trnila/rfm69/hw/sensor/models/RFM69HW.STEP

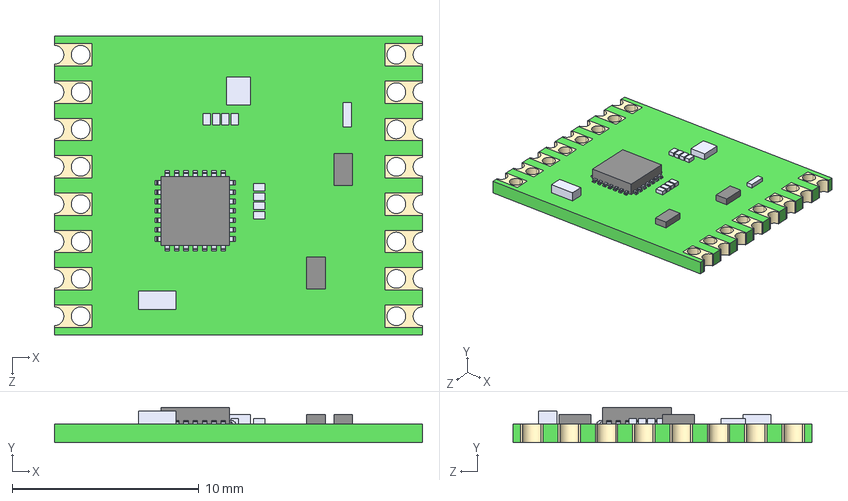
[picture p1: CAD file, 2024-07-25]
hw/sensor/models/RFM69HW.STEP
19.7 x 1.90 x 16.0 mm
