trnila/rfm69/hw/sensor/models/KF128-2.54-2P.step

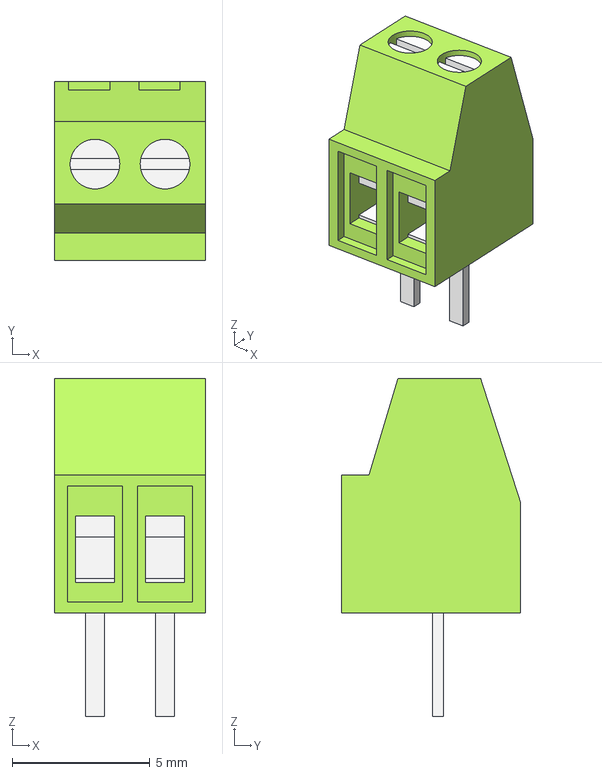
[picture p2: CAD file, 2024-07-25]
hw/sensor/models/KF128-2.54-2P.step
5.48 x 6.50 x 12.3 mm
Housing
PlasticBody
