trnila/rfm69/hw/panel/panel.kicad_pcb

## KiCad design hw/panel/panel.kicad_pcb (2024-07-29)

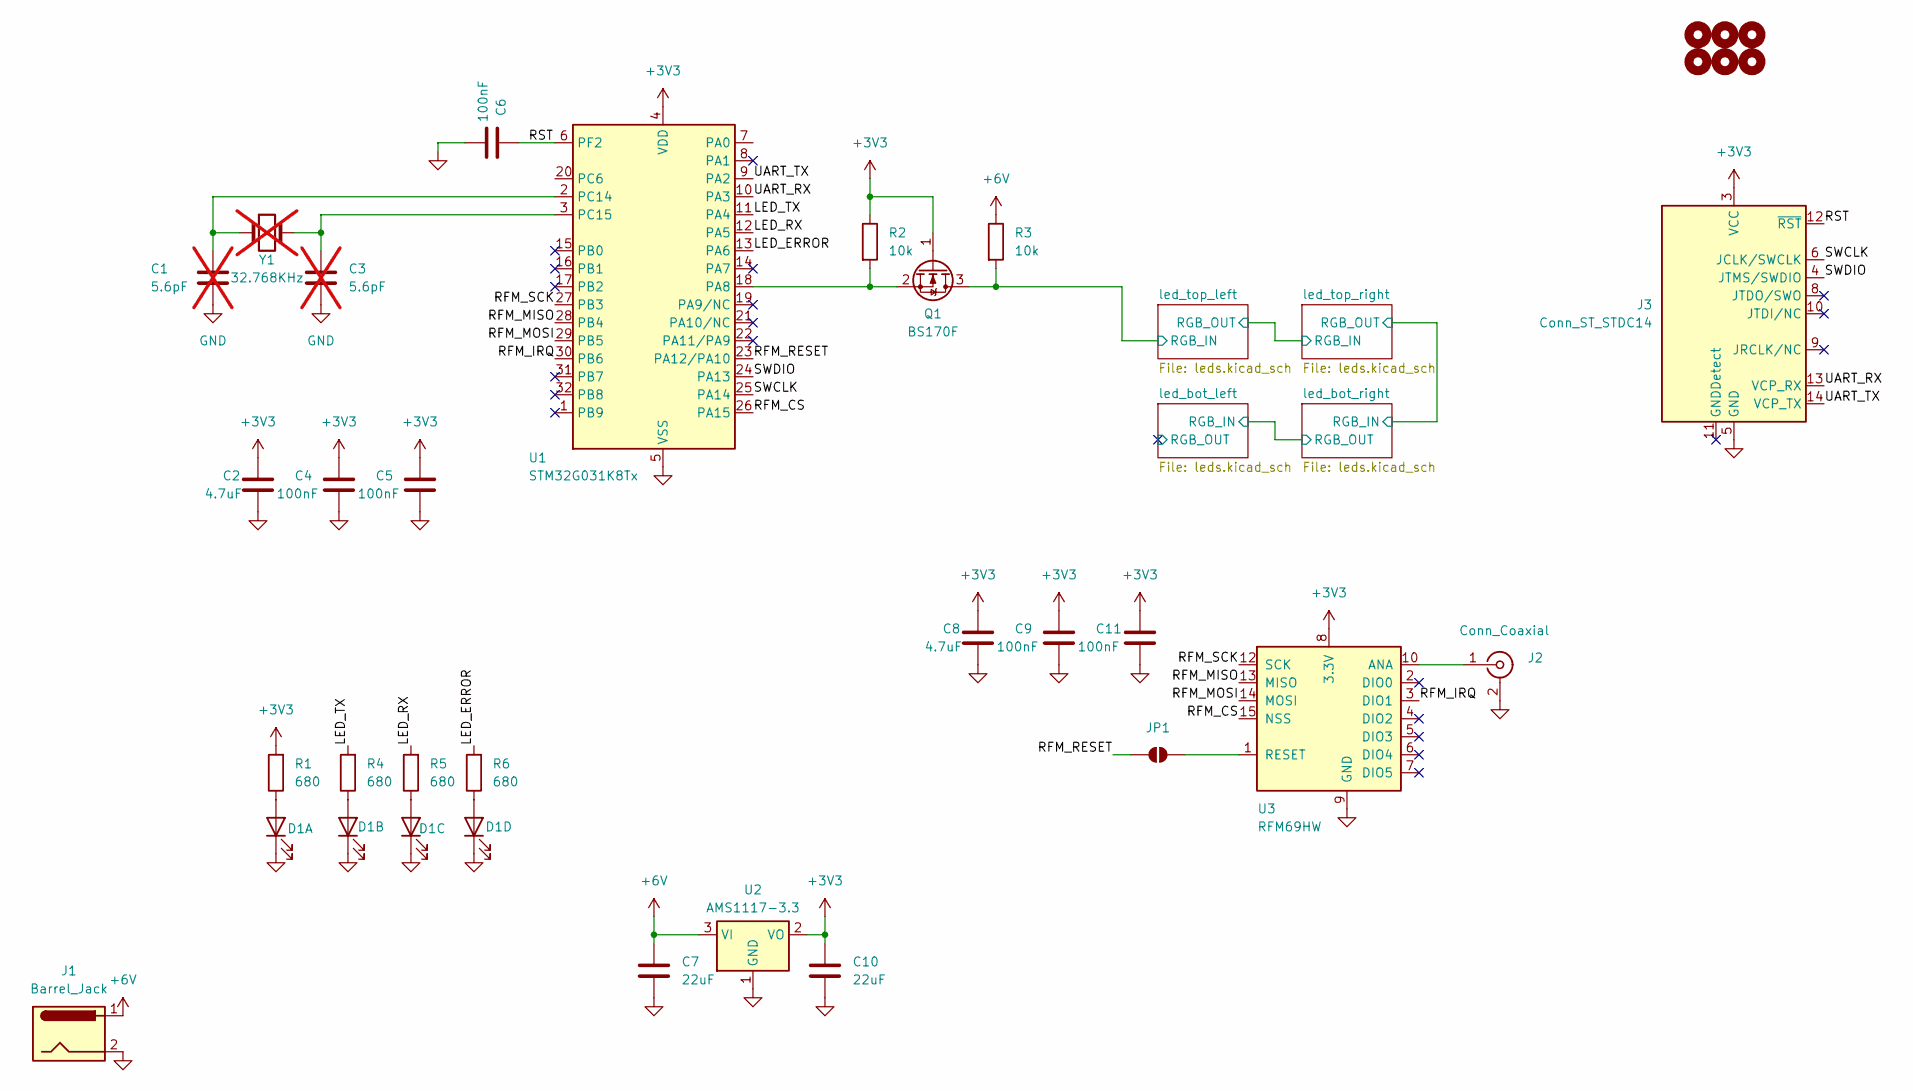
[picture p3: schematic panel.kicad_sch]

Parts:
C1, C3: 5.6pF; C_0805_2012Metric_Pad1.18x1.45mm_HandSolder; not fitted
C2, C8: 4.7uF; C_0805_2012Metric_Pad1.18x1.45mm_HandSolder
C4, C5, C6, C9, C11: 100nF; C_0805_2012Metric_Pad1.18x1.45mm_HandSolder
C7, C10: 22uF; C_1210_3225Metric
D1: light_guide
H1, H2, H3, H4, H200, H201: MountingHole; MountingHole_3.2mm_M3
J1: Barrel_Jack; Molex_Micro-Fit_3.0_43650-0200_1x02_P3.00mm_Horizontal
J2: Conn_Coaxial; SMA_Amphenol_901-143_Horizontal
J3: Conn_ST_STDC14; PinHeader_2x07_P1.27mm_Horizontal
JP1: SolderJumper_2_Bridged; SolderJumper-2_P1.3mm_Open_TrianglePad1.0x1.5mm
Q1: BS170F; SOT-23
R1, R4, R5, R6: 680; R_0805_2012Metric_Pad1.20x1.40mm_HandSolder
R2, R3: 10k; R_0805_2012Metric_Pad1.20x1.40mm_HandSolder
U1: STM32G031K8Tx; LQFP-32_7x7mm_P0.8mm
U2: AMS1117-3.3; SOT-223-3_TabPin2
U3: RFM69HW; HOPERF_RFM69HW
Y1: 32.768KHz; Crystal_SMD_3215-2Pin_3.2x1.5mm; not fitted

Connections:
+3V3: C2.1, C4.1, C5.1, C8.1, C9.1, C10.1, C11.1, J3.3 (VCC), Q1.1 (G), R1.2, R2.1, U1.4 (VDD), U2.2 (VO), U3.8 (3.3V)
+6V: C7.1, J1.1, R3.1, U2.3 (VI); also elsewhere on the board
/LED_ERROR: R6.2, U1.13 (PA6)
/LED_RX: R5.2, U1.12 (PA5)
/LED_TX: R4.2, U1.11 (PA4)
/RFM_CS: U1.26 (PA15), U3.15 (NSS)
/RFM_IRQ: U1.30 (PB6), U3.3 (DIO1)
/RFM_MISO: U1.28 (PB4), U3.13 (MISO)
/RFM_MOSI: U1.29 (PB5), U3.14 (MOSI)
/RFM_RESET: JP1.2 (B), U1.23 (PA12/PA10)
/RFM_SCK: U1.27 (PB3), U3.12 (SCK)
/RST: C6.1, J3.12 (~RST), U1.6 (PF2)
/SWCLK: J3.6 (JCLK/SWCLK), U1.25 (PA14)
/SWDIO: J3.4 (JTMS/SWDIO), U1.24 (PA13)
/UART_RX: J3.13 (VCP_RX), U1.10 (PA3)
/UART_TX: J3.14 (VCP_TX), U1.9 (PA2)
/led_top_left/RGB_IN: Q1.3 (D), R3.2; also elsewhere on the board
GND: C1.2, C2.2, C3.2, C4.2, C5.2, C6.2, C7.2, C8.2, C9.2, C10.2, C11.2, D1.1 (K), D1.3 (K), D1.5 (K), D1.7 (K), J1.2, J2.2 (Ext), J3.5 (GND), J3.7 (GND), U1.5 (VSS), U2.1 (GND), U3.9 (GND), U3.11 (GND); also elsewhere on the board
unnamed: D1.2 (A), R1.1
unnamed: D1.4 (A), R4.1
unnamed: D1.6 (A), R5.1
unnamed: D1.8 (A), R6.1
unnamed: J2.1 (In), U3.10 (ANA)
unnamed: JP1.1 (A), U3.1 (RESET)
unnamed: Q1.2 (S), R2.2, U1.18 (PA8)
unnamed: C1.1, U1.2 (PC14), Y1.1
unnamed: C3.1, U1.3 (PC15), Y1.2

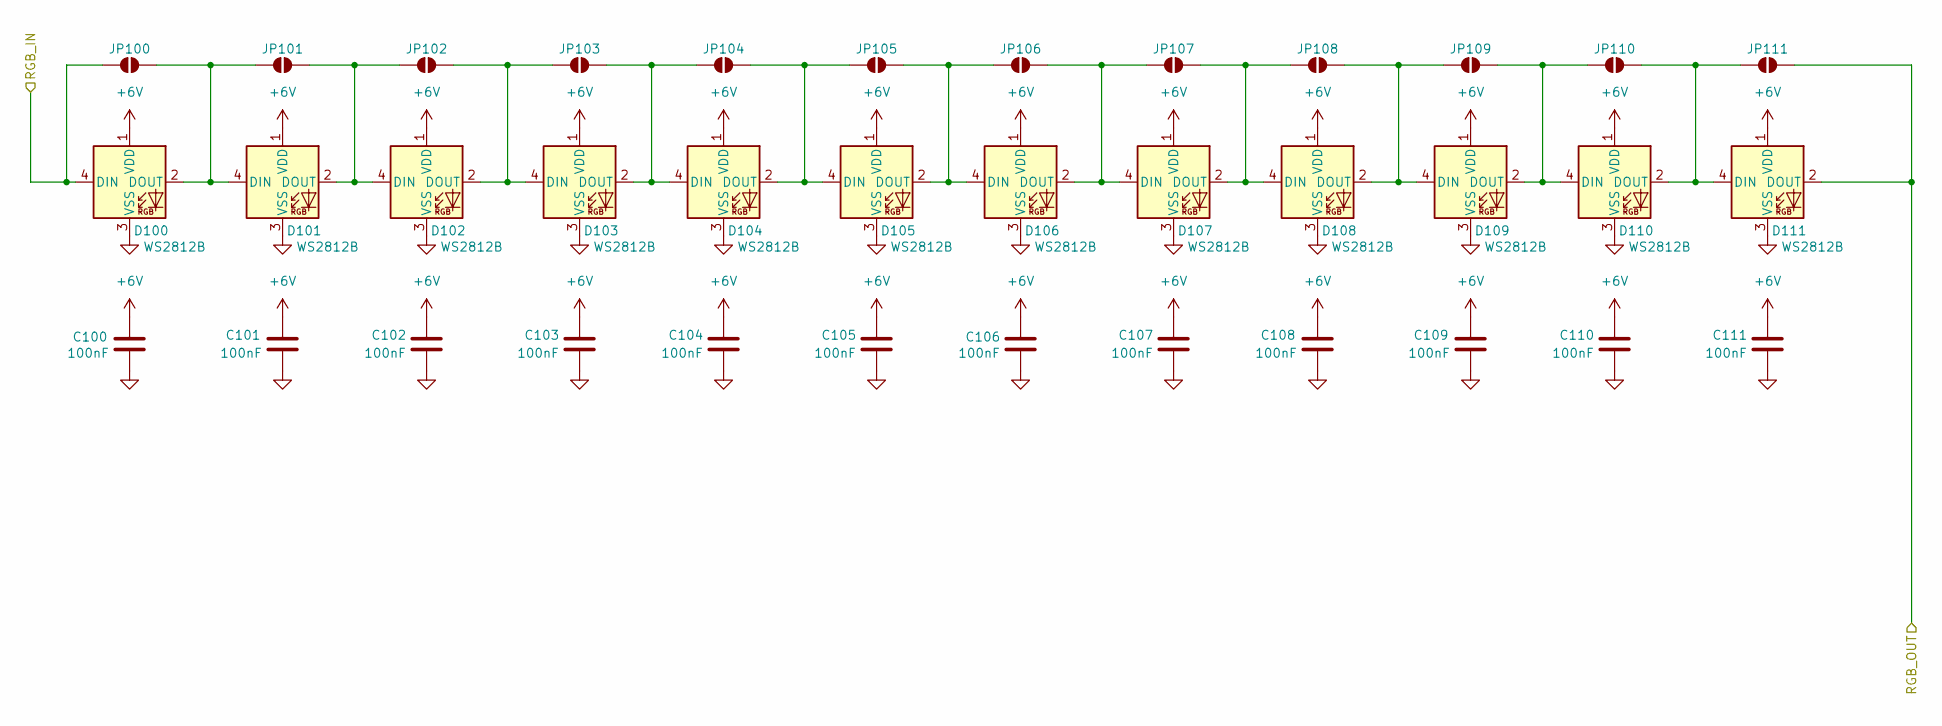
[picture p4: schematic leds.kicad_sch]

Parts:
C100, C101, C102, C103, C104, C105, C106, C107, C108, C109, C110, C111: 100nF; C_0805_2012Metric_Pad1.18x1.45mm_HandSolder
D100, D101, D102, D103, D104, D105, D106, D107, D108, D109, D110, D111: WS2812B; LED_WS2812B_PLCC4_5.0x5.0mm_P3.2mm
JP100, JP101, JP102, JP103, JP104, JP105, JP106, JP107, JP108, JP109, JP110, JP111: SolderJumper_2_Open; SolderJumper-2_P1.3mm_Open_TrianglePad1.0x1.5mm

Connections:
+6V: C100.1, C101.1, C102.1, C103.1, C104.1, C105.1, C106.1, C107.1, C108.1, C109.1, C110.1, C111.1, D100.1 (VDD), D101.1 (VDD), D102.1 (VDD), D103.1 (VDD), D104.1 (VDD), D105.1 (VDD), D106.1 (VDD), D107.1 (VDD), D108.1 (VDD), D109.1 (VDD), D110.1 (VDD), D111.1 (VDD); also elsewhere on the board
/led_top_left/RGB_IN: D100.4 (DIN), JP100.1 (A); also elsewhere on the board
/led_top_left/RGB_OUT: D111.2 (DOUT), JP111.2 (B); also elsewhere on the board
GND: C100.2, C101.2, C102.2, C103.2, C104.2, C105.2, C106.2, C107.2, C108.2, C109.2, C110.2, C111.2, D100.3 (VSS), D101.3 (VSS), D102.3 (VSS), D103.3 (VSS), D104.3 (VSS), D105.3 (VSS), D106.3 (VSS), D107.3 (VSS), D108.3 (VSS), D109.3 (VSS), D110.3 (VSS), D111.3 (VSS); also elsewhere on the board
unnamed: D100.2 (DOUT), D101.4 (DIN), JP100.2 (B), JP101.1 (A)
unnamed: D101.2 (DOUT), D102.4 (DIN), JP101.2 (B), JP102.1 (A)
unnamed: D102.2 (DOUT), D103.4 (DIN), JP102.2 (B), JP103.1 (A)
unnamed: D103.2 (DOUT), D104.4 (DIN), JP103.2 (B), JP104.1 (A)
unnamed: D104.2 (DOUT), D105.4 (DIN), JP104.2 (B), JP105.1 (A)
unnamed: D105.2 (DOUT), D106.4 (DIN), JP105.2 (B), JP106.1 (A)
unnamed: D106.2 (DOUT), D107.4 (DIN), JP106.2 (B), JP107.1 (A)
unnamed: D107.2 (DOUT), D108.4 (DIN), JP107.2 (B), JP108.1 (A)
unnamed: D108.2 (DOUT), D109.4 (DIN), JP108.2 (B), JP109.1 (A)
unnamed: D109.2 (DOUT), D110.4 (DIN), JP109.2 (B), JP110.1 (A)
unnamed: D110.2 (DOUT), D111.4 (DIN), JP110.2 (B), JP111.1 (A)

Parts of its further copies:
C112, C113, C114, C115, C116, C117, C118, C119, C120, C121, C122, C123, C200, C201, C202, C203, C204, C205, C206, C207, C208, C209, C210, C211, C212, C213, C214, C215, C216, C217, C218, C219, C220, C221, C222, C223: 100nF; C_0805_2012Metric_Pad1.18x1.45mm_HandSolder
D112, D113, D114, D115, D116, D117, D118, D119, D120, D121, D122, D123, D200, D201, D202, D203, D204, D205, D206, D207, D208, D209, D210, D211, D212, D213, D214, D215, D216, D217, D218, D219, D220, D221, D222, D223: WS2812B; LED_WS2812B_PLCC4_5.0x5.0mm_P3.2mm
JP112, JP113, JP114, JP115, JP116, JP117, JP118, JP119, JP120, JP121, JP122, JP123, JP200, JP201, JP202, JP203, JP204, JP205, JP206, JP207, JP208, JP209, JP210, JP211, JP212, JP213, JP214, JP215, JP216, JP217, JP218, JP219, JP220, JP221, JP222, JP223: SolderJumper_2_Open; SolderJumper-2_P1.3mm_Open_TrianglePad1.0x1.5mm

Connections of its further copies:
+6V: C112.1, C113.1, C114.1, C115.1, C116.1, C117.1, C118.1, C119.1, C120.1, C121.1, C122.1, C123.1, C200.1, C201.1, C202.1, C203.1, C204.1, C205.1, C206.1, C207.1, C208.1, C209.1, C210.1, C211.1, C212.1, C213.1, C214.1, C215.1, C216.1, C217.1, C218.1, C219.1, C220.1, C221.1, C222.1, C223.1, D112.1 (VDD), D113.1 (VDD), D114.1 (VDD), D115.1 (VDD), D116.1 (VDD), D117.1 (VDD), D118.1 (VDD), D119.1 (VDD), D120.1 (VDD), D121.1 (VDD), D122.1 (VDD), D123.1 (VDD), D200.1 (VDD), D201.1 (VDD), D202.1 (VDD), D203.1 (VDD), D204.1 (VDD), D205.1 (VDD), D206.1 (VDD), D207.1 (VDD), D208.1 (VDD), D209.1 (VDD), D210.1 (VDD), D211.1 (VDD), D212.1 (VDD), D213.1 (VDD), D214.1 (VDD), D215.1 (VDD), D216.1 (VDD), D217.1 (VDD), D218.1 (VDD), D219.1 (VDD), D220.1 (VDD), D221.1 (VDD), D222.1 (VDD), D223.1 (VDD); also elsewhere on the board
/led_bot_left/RGB_IN: D211.2 (DOUT), D212.4 (DIN), JP211.2 (B), JP212.1 (A)
/led_bot_left/RGB_OUT: D223.2 (DOUT), JP223.2 (B)
/led_bot_right/RGB_IN: D123.2 (DOUT), D200.4 (DIN), JP123.2 (B), JP200.1 (A)
/led_top_left/RGB_OUT: D112.4 (DIN), JP112.1 (A); also elsewhere on the board
GND: C112.2, C113.2, C114.2, C115.2, C116.2, C117.2, C118.2, C119.2, C120.2, C121.2, C122.2, C123.2, C200.2, C201.2, C202.2, C203.2, C204.2, C205.2, C206.2, C207.2, C208.2, C209.2, C210.2, C211.2, C212.2, C213.2, C214.2, C215.2, C216.2, C217.2, C218.2, C219.2, C220.2, C221.2, C222.2, C223.2, D112.3 (VSS), D113.3 (VSS), D114.3 (VSS), D115.3 (VSS), D116.3 (VSS), D117.3 (VSS), D118.3 (VSS), D119.3 (VSS), D120.3 (VSS), D121.3 (VSS), D122.3 (VSS), D123.3 (VSS), D200.3 (VSS), D201.3 (VSS), D202.3 (VSS), D203.3 (VSS), D204.3 (VSS), D205.3 (VSS), D206.3 (VSS), D207.3 (VSS), D208.3 (VSS), D209.3 (VSS), D210.3 (VSS), D211.3 (VSS), D212.3 (VSS), D213.3 (VSS), D214.3 (VSS), D215.3 (VSS), D216.3 (VSS), D217.3 (VSS), D218.3 (VSS), D219.3 (VSS), D220.3 (VSS), D221.3 (VSS), D222.3 (VSS), D223.3 (VSS); also elsewhere on the board
unnamed: D112.2 (DOUT), D113.4 (DIN), JP112.2 (B), JP113.1 (A)
unnamed: D113.2 (DOUT), D114.4 (DIN), JP113.2 (B), JP114.1 (A)
unnamed: D114.2 (DOUT), D115.4 (DIN), JP114.2 (B), JP115.1 (A)
unnamed: D115.2 (DOUT), D116.4 (DIN), JP115.2 (B), JP116.1 (A)
unnamed: D116.2 (DOUT), D117.4 (DIN), JP116.2 (B), JP117.1 (A)
unnamed: D117.2 (DOUT), D118.4 (DIN), JP117.2 (B), JP118.1 (A)
unnamed: D118.2 (DOUT), D119.4 (DIN), JP118.2 (B), JP119.1 (A)
unnamed: D119.2 (DOUT), D120.4 (DIN), JP119.2 (B), JP120.1 (A)
unnamed: D120.2 (DOUT), D121.4 (DIN), JP120.2 (B), JP121.1 (A)
unnamed: D121.2 (DOUT), D122.4 (DIN), JP121.2 (B), JP122.1 (A)
unnamed: D122.2 (DOUT), D123.4 (DIN), JP122.2 (B), JP123.1 (A)
unnamed: D200.2 (DOUT), D201.4 (DIN), JP200.2 (B), JP201.1 (A)
unnamed: D201.2 (DOUT), D202.4 (DIN), JP201.2 (B), JP202.1 (A)
unnamed: D202.2 (DOUT), D203.4 (DIN), JP202.2 (B), JP203.1 (A)
unnamed: D203.2 (DOUT), D204.4 (DIN), JP203.2 (B), JP204.1 (A)
unnamed: D204.2 (DOUT), D205.4 (DIN), JP204.2 (B), JP205.1 (A)
unnamed: D205.2 (DOUT), D206.4 (DIN), JP205.2 (B), JP206.1 (A)
unnamed: D206.2 (DOUT), D207.4 (DIN), JP206.2 (B), JP207.1 (A)
unnamed: D207.2 (DOUT), D208.4 (DIN), JP207.2 (B), JP208.1 (A)
unnamed: D208.2 (DOUT), D209.4 (DIN), JP208.2 (B), JP209.1 (A)
unnamed: D209.2 (DOUT), D210.4 (DIN), JP209.2 (B), JP210.1 (A)
unnamed: D210.2 (DOUT), D211.4 (DIN), JP210.2 (B), JP211.1 (A)
unnamed: D212.2 (DOUT), D213.4 (DIN), JP212.2 (B), JP213.1 (A)
unnamed: D213.2 (DOUT), D214.4 (DIN), JP213.2 (B), JP214.1 (A)
unnamed: D214.2 (DOUT), D215.4 (DIN), JP214.2 (B), JP215.1 (A)
unnamed: D215.2 (DOUT), D216.4 (DIN), JP215.2 (B), JP216.1 (A)
unnamed: D216.2 (DOUT), D217.4 (DIN), JP216.2 (B), JP217.1 (A)
unnamed: D217.2 (DOUT), D218.4 (DIN), JP217.2 (B), JP218.1 (A)
unnamed: D218.2 (DOUT), D219.4 (DIN), JP218.2 (B), JP219.1 (A)
unnamed: D219.2 (DOUT), D220.4 (DIN), JP219.2 (B), JP220.1 (A)
unnamed: D220.2 (DOUT), D221.4 (DIN), JP220.2 (B), JP221.1 (A)
unnamed: D221.2 (DOUT), D222.4 (DIN), JP221.2 (B), JP222.1 (A)
unnamed: D222.2 (DOUT), D223.4 (DIN), JP222.2 (B), JP223.1 (A)

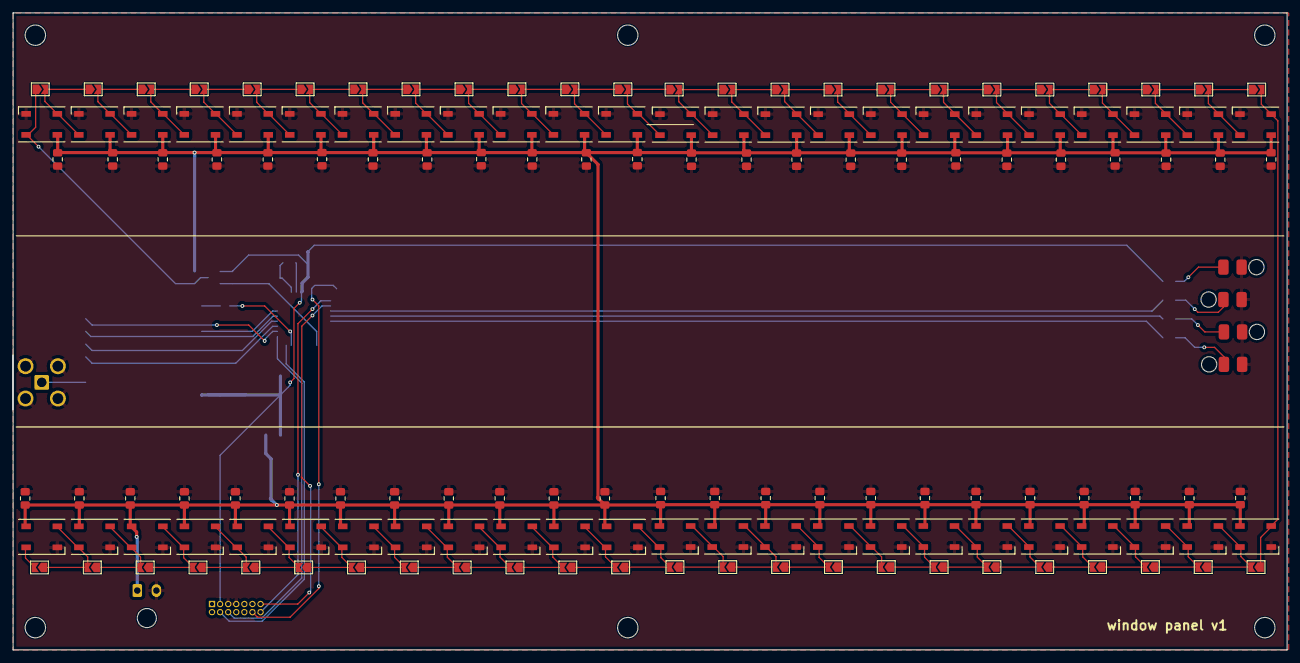
[picture p5: board panel.kicad_pcb from above]

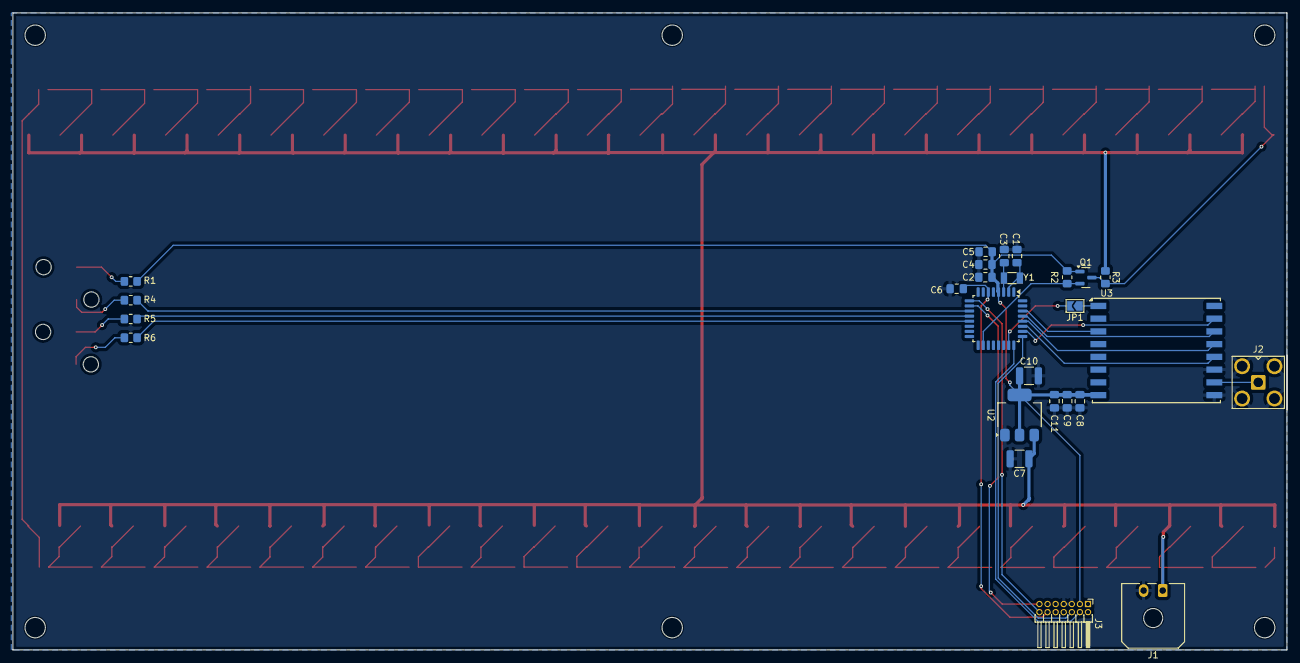
[picture p6: board panel.kicad_pcb from below]

Board: 2 copper layers, 200.0 x 100.0 mm, 177 parts (26 on the bottom side), 75 nets.
