trnila/rfm69/hw/sensor/sensor.kicad_pcb

## KiCad design hw/sensor/sensor.kicad_pcb (2024-07-26)

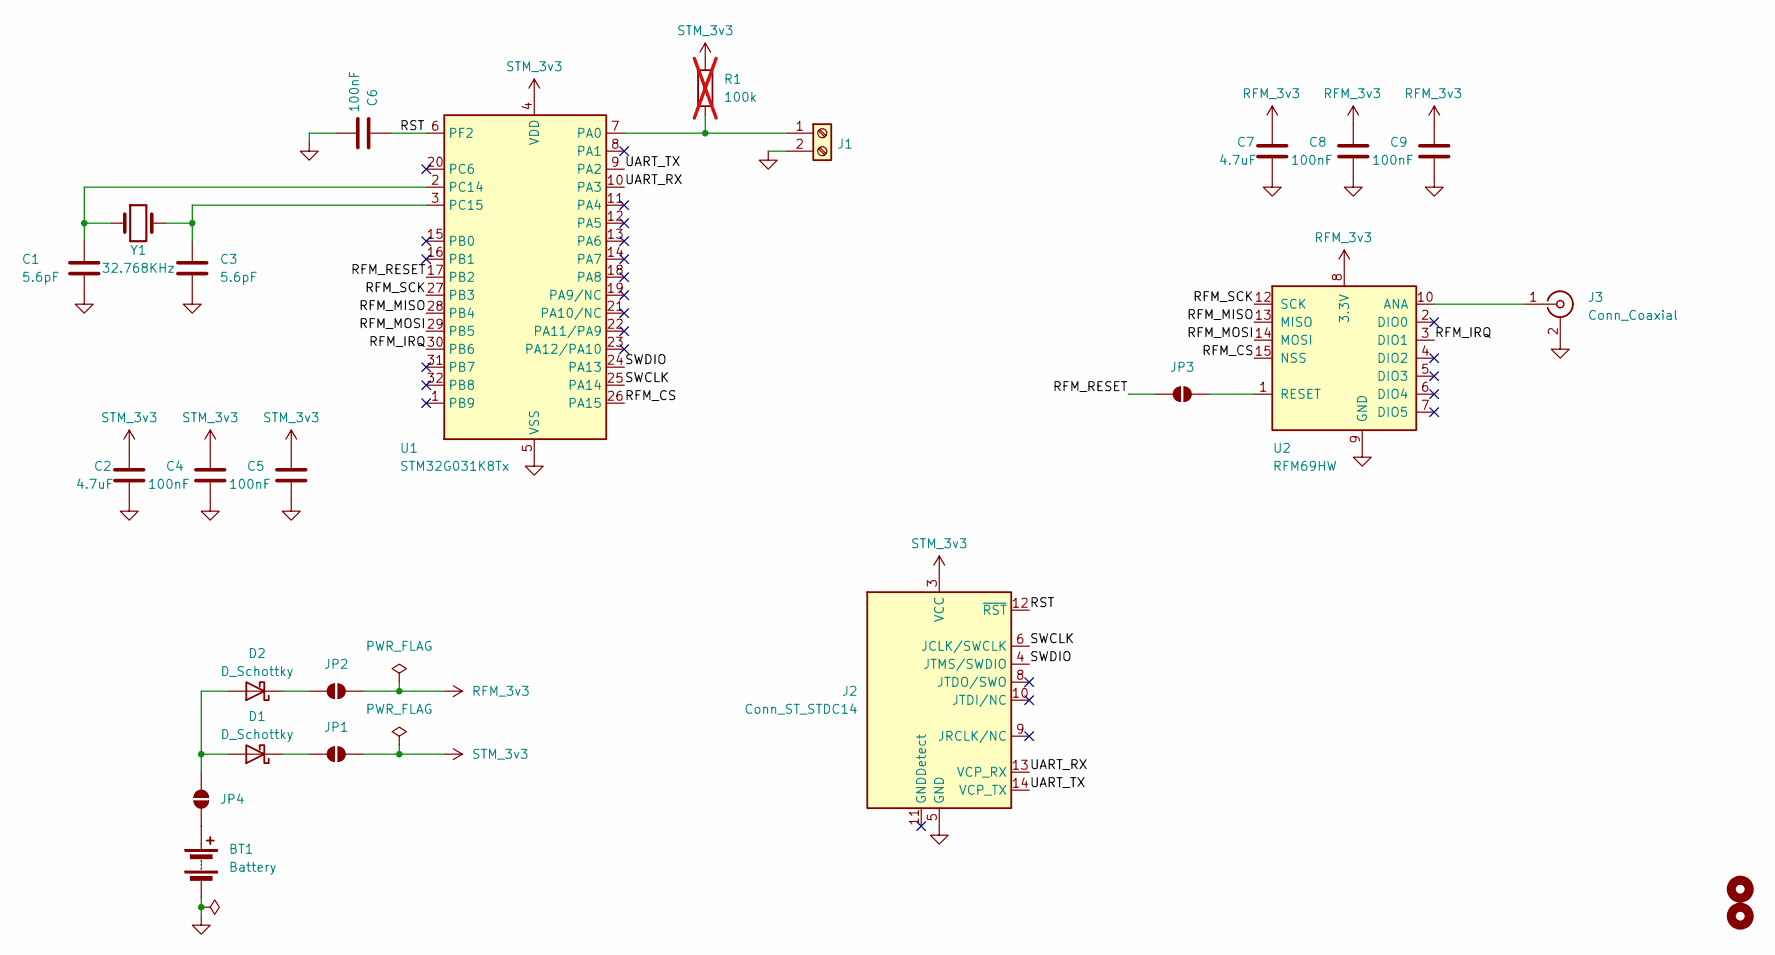
[picture p7: schematic sensor.kicad_sch]

Parts:
BT1: Battery; BatteryHolder_Keystone_2462_2xAA
C1, C3: 5.6pF; C_0805_2012Metric_Pad1.18x1.45mm_HandSolder
C2, C7: 4.7uF; C_0805_2012Metric_Pad1.18x1.45mm_HandSolder
C4, C5, C6, C8, C9: 100nF; C_0805_2012Metric_Pad1.18x1.45mm_HandSolder
D1, D2: D_Schottky; D_SOD-323_HandSoldering
H1, H4: MountingHole; MountingHole_3.2mm_M3
J1: Screw_Terminal_01x02; TerminalBlock_Xinya_XY308-2.54-2P_1x02_P2.54mm_Horizontal
J2: Conn_ST_STDC14; PinHeader_2x07_P1.27mm_Vertical
J3: Conn_Coaxial; SMA_Amphenol_901-143_Horizontal
JP1, JP2, JP3, JP4: SolderJumper_2_Bridged; SolderJumper-2_P1.3mm_Open_TrianglePad1.0x1.5mm
R1: 100k; R_0805_2012Metric_Pad1.20x1.40mm_HandSolder; not fitted
U1: STM32G031K8Tx; LQFP-32_7x7mm_P0.8mm
U2: RFM69HW; HOPERF_RFM69HW
Y1: 32.768KHz; Crystal_SMD_3215-2Pin_3.2x1.5mm

Connections:
/RFM_CS: U1.26 (PA15), U2.15 (NSS)
/RFM_IRQ: U1.30 (PB6), U2.3 (DIO1)
/RFM_MISO: U1.28 (PB4), U2.13 (MISO)
/RFM_MOSI: U1.29 (PB5), U2.14 (MOSI)
/RFM_RESET: JP3.2 (B), U1.17 (PB2)
/RFM_SCK: U1.27 (PB3), U2.12 (SCK)
/RST: C6.1, J2.12 (~RST), U1.6 (PF2)
/SWCLK: J2.6 (JCLK/SWCLK), U1.25 (PA14)
/SWDIO: J2.4 (JTMS/SWDIO), U1.24 (PA13)
/UART_RX: J2.13 (VCP_RX), U1.10 (PA3)
/UART_TX: J2.14 (VCP_TX), U1.9 (PA2)
GND: BT1.2 (-), C1.2, C2.2, C3.2, C4.2, C5.2, C6.2, C7.2, C8.2, C9.2, J1.2, J2.5 (GND), J2.7 (GND), J3.2 (Ext), U1.5 (VSS), U2.9 (GND), U2.11 (GND)
unnamed: BT1.1 (+), JP4.1 (A)
unnamed: D1.2 (A), D2.2 (A), JP4.2 (B)
unnamed: D1.1 (K), JP1.2 (B)
unnamed: D2.1 (K), JP2.2 (B)
unnamed: J1.1, R1.2, U1.7 (PA0)
unnamed: J3.1 (In), U2.10 (ANA)
unnamed: JP3.1 (A), U2.1 (RESET)
unnamed: C1.1, U1.2 (PC14), Y1.1
unnamed: C3.1, U1.3 (PC15), Y1.2
RFM_3v3: C7.1, C8.1, C9.1, JP2.1 (A), U2.8 (3.3V)
STM_3v3: C2.1, C4.1, C5.1, J2.3 (VCC), JP1.1 (A), R1.1, U1.4 (VDD)

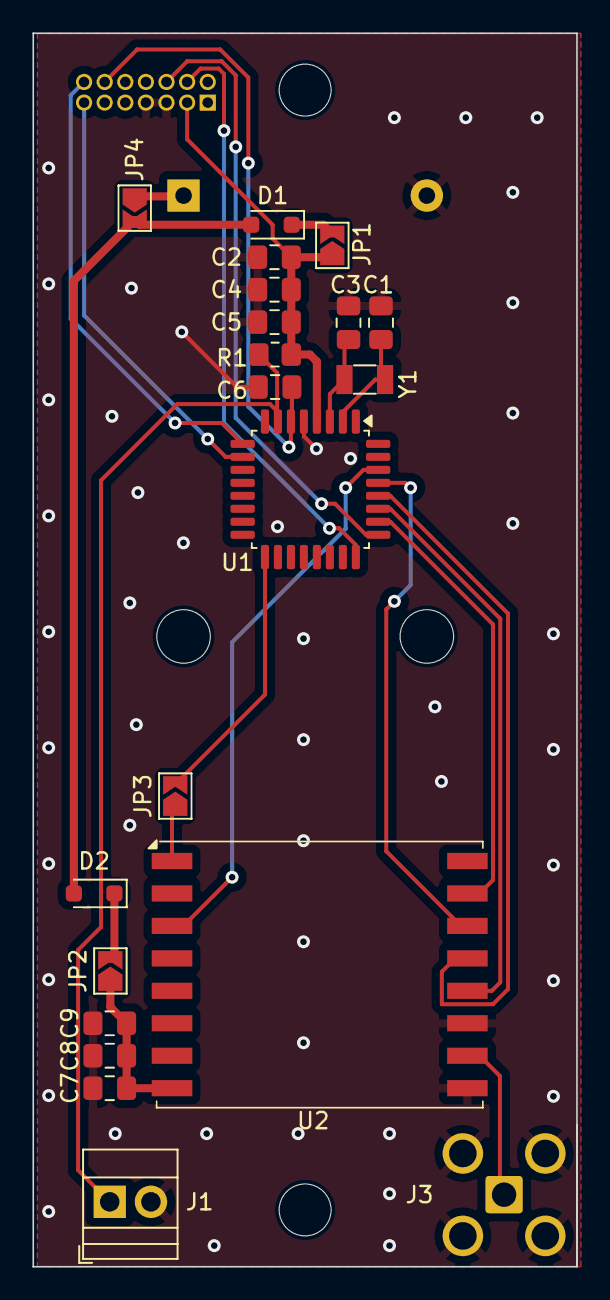
[picture p8: board sensor.kicad_pcb from above]

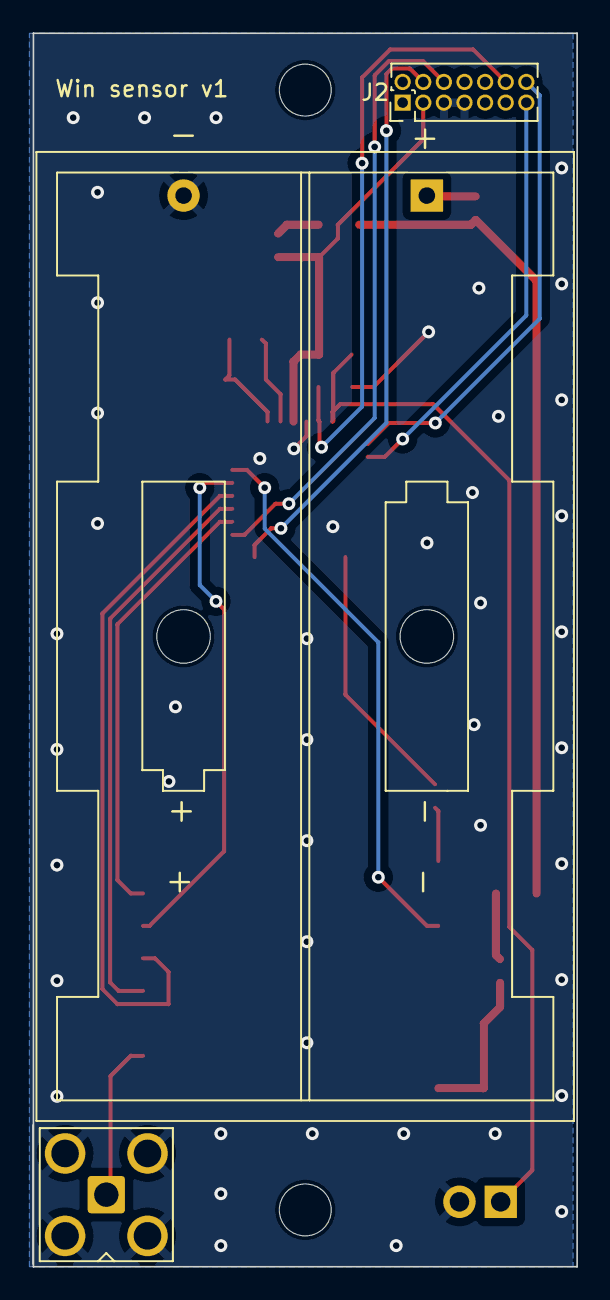
[picture p9: board sensor.kicad_pcb from below]

Board: 2 copper layers, 33.5 x 76.0 mm, 25 parts (3 on the bottom side), 23 nets.
