trnila/rfm69/src/sensors.h

#define SENSOR_BATTERY_CURRENT 0
#define SENSOR_BATTERY_VOLTAGE 1
#define SENSOR_SOLAR_VOLTAGE 2
#define SENSOR_TEMPERATURE 3
#define SENSOR_HUMIDITY 4
#define SENSOR_PRED_GARAZI 5
#define SENSOR_BATERKA 6
#define SENSOR_VREF 7
#define SENSOR_VBAT 8
#define SENSOR_WINDOW 9
