trnila/rfm69/src/adc.h

#pragma once

#include <stdint.h>

typedef struct {
  uint16_t bat_I_mV;
  uint16_t bat_V_mV;
  uint16_t solar_V_mV;
  uint16_t vref_mV;
  uint16_t vbat_mV;
} adc_measurements_t;

void adc_init();
void adc_read(adc_measurements_t *res);
