trnila/rfm69/(commit log)

2023-11-02 RFM69: node filtering
2023-11-12 gw.py: support cover sensors
2023-11-12 rgb: send signal only on change and if there is no pending DMA request
2023-11-12 timers: added initial impl
2023-11-12 RFM69: async DMA implementation with ack and retransmissions
2023-11-12 sensor: use timer instead of loop count
    timer header
    x
2023-11-12 sensor: added window sensor
2023-11-12 Send and receive multiple sensors in one radio packet
2023-11-20 Added all devices into .vscode/launch.json
2023-11-25 Run sensor on 1Mhz clock
2023-11-26 UART: configurable clock in and baud rate
2023-12-12 Use PA0 for window sensor
2023-12-12 window sensor: go to shutdown after window was closed/opened and periodically
2024-07-20 Replace after-main infinite loop with [[noreturn]]
    [sensor.c, startup.c]
2024-07-20 Added sensor hw
    [window_sensor.kicad_pcb, window_sensor.kicad_sch]
2024-07-20 new version of kicad
    [window_sensor.kicad_sch]
2024-07-20 removed step-up, using direct VBAT
    [window_sensor.kicad_sch]
2024-07-20 debugging connectors unified to one
    [window_sensor.kicad_pcb, window_sensor.kicad_sch]
2024-07-21 moved wakeup to PA0
    [window_sensor.kicad_sch]
2024-07-21 optional external pull-up for sensor pin
    [window_sensor.kicad_sch]
2024-07-25 pcb updated
    [window_sensor.kicad_pcb, window_sensor.kicad_sch]
2024-07-25 First PCB
    [window_sensor.kicad_pcb, window_sensor.kicad_sch]
2024-07-25 renamed and moved
    [KF128-2.54-2P.step, RFM69HW.STEP, sensor.kicad_pcb, sensor.kicad_sch]
2024-07-25 Added pannel
    [leds.kicad_sch, panel.kicad_pcb, panel.kicad_sch]
2024-07-26 sensor redesigned
    [sensor.kicad_pcb, sensor.kicad_sch]
2024-07-28 panel progress
    [panel.kicad_pcb, panel.kicad_sch]
2024-07-28 extend top to 200mm
    [leds.kicad_sch, panel.kicad_pcb, panel.kicad_sch]
2024-07-28 bot left
    [leds.kicad_sch, panel.kicad_pcb, panel.kicad_sch]
2024-07-28 Added bot right
    [leds.kicad_sch, panel.kicad_pcb, panel.kicad_sch]
2024-07-28 optimized paths
    [panel.kicad_pcb]
